whisperingin/hand-gesture-recognition/最终改print版本.txt

/* USER CODE BEGIN Header */
/**
  ******************************************************************************
  * @file           : main.c
  * @brief          : Main program body
  ******************************************************************************
  * @attention
  *
  * Copyright (c) 2026 STMicroelectronics.
  * All rights reserved.
  *
  * This software is licensed under terms that can be found in the LICENSE file
  * in the root directory of this software component.
  * If no LICENSE file comes with this software, it is provided AS-IS.
  *
  ******************************************************************************
  */
/* USER CODE END Header */
/* Includes ------------------------------------------------------------------*/
#include "main.h"

/* Private includes ----------------------------------------------------------*/
/* USER CODE BEGIN Includes */
#include <string.h>
/* USER CODE END Includes */

/* Private typedef -----------------------------------------------------------*/
/* USER CODE BEGIN PTD */
typedef struct {
    float x[3]; // 输入历史: x[n], x[n-1], x[n-2]
    float y[3]; // 输出历史: y[n], y[n-1], y[n-2]
    float b[3]; // 分子系数
    float a[3]; // 分母系数
} BiquadFilter;
/* USER CODE END PTD */

/* Private define ------------------------------------------------------------*/
/* USER CODE BEGIN PD */

/* USER CODE END PD */

/* Private macro -------------------------------------------------------------*/
/* USER CODE BEGIN PM */

/* USER CODE END PM */

/* Private variables ---------------------------------------------------------*/
ADC_HandleTypeDef hadc1;
DMA_HandleTypeDef hdma_adc1;

TIM_HandleTypeDef htim2;

UART_HandleTypeDef huart2;
DMA_HandleTypeDef hdma_usart2_tx;

/* USER CODE BEGIN PV */
#define N_CH 4
/* 每次处理多少帧，fs=2000Hz 时，20 帧表示 10 ms 一次处理 */
#define FRAMES_PER_BLOCK 20

#define ADC_HALF_LEN (N_CH * FRAMES_PER_BLOCK)
#define ADC_DMA_LEN  (2 * ADC_HALF_LEN)

/* CSV 很占空间，20 行一包建议至少 700 字节，这里留 1024 比较稳 */
#define TX_BUF_SIZE 1024

/* ADC DMA 循环双缓冲，数据排列为
   ch0 ch1 ch2 ch3 | ch0 ch1 ch2 ch3 | ...
*/
uint16_t adc_dma_buf[ADC_DMA_LEN];

/* DMA 半传输和全传输标志 */
volatile uint8_t adc_half_ready;
volatile uint8_t adc_full_ready;

/* 处理后的一个 block 输出缓冲 */
uint16_t filt_block[ADC_HALF_LEN];

/* 每个通道各自一套滤波器状态 */
BiquadFilter notch50[N_CH];
BiquadFilter highpass20[N_CH]; // 改为 20Hz
BiquadFilter lowpass400_s1[N_CH]; // 四阶滤波器的第一级
BiquadFilter lowpass400_s2[N_CH]; // 四阶滤波器的第二级

/* UART DMA 发送控制 */
volatile uint8_t uart_tx_busy;
uint8_t tx_buf[2][TX_BUF_SIZE];
volatile uint8_t tx_sel;
volatile uint32_t adc_half_overrun;
volatile uint32_t adc_full_overrun;
#define WARMUP_BLOCKS 50U   /* 50 block * 10 ms = 500 ms (fs=2000Hz, 20帧/block) */
volatile uint32_t warmup_left = WARMUP_BLOCKS;

/* USER CODE END PV */

/* Private function prototypes -----------------------------------------------*/
void SystemClock_Config(void);
static void MX_GPIO_Init(void);
static void MX_DMA_Init(void);
static void MX_USART2_UART_Init(void);
static void MX_ADC1_Init(void);
static void MX_TIM2_Init(void);
/* USER CODE BEGIN PFP */
static void ProcessBlock(const uint16_t* in, uint16_t* out, int frames);
static void TryUartSendCsvBlock(const uint16_t* out, int frames);
static inline int u16_to_ascii(uint16_t v, char *dst);
static inline int append_u16_csv4_line(char *dst, int remaining,
                                       uint16_t a, uint16_t b, uint16_t c, uint16_t d);
/* USER CODE END PFP */

/* Private user code ---------------------------------------------------------*/
/* USER CODE BEGIN 0 */
static void Filter_Init(void)
{
    for (int ch = 0; ch < N_CH; ch++)
    {
    	/* 50 Hz notch, fs=2000, Q=5 */
    	notch50[ch].b[0] = 0.9845975f;
    	notch50[ch].b[1] = -1.9449509f;
    	notch50[ch].b[2] = 0.9845975f;

    	notch50[ch].a[0] = 1.0f;
    	notch50[ch].a[1] = -1.9449509f;
    	notch50[ch].a[2] = 0.9691950f;

    	/* 20 Hz highpass, fs=2000, Butterworth Q=0.70710678 */
    	highpass20[ch].b[0] = 0.9565432f;
    	highpass20[ch].b[1] = -1.9130865f;
    	highpass20[ch].b[2] = 0.9565432f;

    	highpass20[ch].a[0] = 1.0f;
    	highpass20[ch].a[1] = -1.9111971f;
    	highpass20[ch].a[2] = 0.9149758f;

    	// 在 Filter_Init() 中替换原有的 lowpass400 初始化代码：

    	/* 400 Hz Lowpass, 4th-Order Butterworth, Stage 1 (Q=0.5412) */
    	lowpass400_s1[ch].b[0] = 0.183921f;
    	lowpass400_s1[ch].b[1] = 0.367842f;
    	lowpass400_s1[ch].b[2] = 0.183921f;
    	lowpass400_s1[ch].a[0] = 1.0f;
    	lowpass400_s1[ch].a[1] = -0.329007f;
    	lowpass400_s1[ch].a[2] = 0.064691f;

    	/* 400 Hz Lowpass, 4th-Order Butterworth, Stage 2 (Q=1.3065) */
    	lowpass400_s2[ch].b[0] = 0.253331f;
    	lowpass400_s2[ch].b[1] = 0.506662f;
    	lowpass400_s2[ch].b[2] = 0.253331f;
    	lowpass400_s2[ch].a[0] = 1.0f;
    	lowpass400_s2[ch].a[1] = -0.453228f;
    	lowpass400_s2[ch].a[2] = 0.466551f;

    	/* 别忘了把它们的状态变量 x[i] 和 y[i] 都在下方循环中初始化为 0.0f */

        /* 初始化所有状态变量为 0 */
        for (int i = 0; i < 3; i++)
        {
            notch50[ch].x[i] = 0.0f;
            notch50[ch].y[i] = 0.0f;

            highpass20[ch].x[i] = 0.0f;
            highpass20[ch].y[i] = 0.0f;

            // 新增：把第一级 (s1) 的输入输出历史清零
            lowpass400_s1[ch].x[i] = 0.0f;
            lowpass400_s1[ch].y[i] = 0.0f;

                        // 新增：把第二级 (s2) 的输入输出历史清零
            lowpass400_s2[ch].x[i] = 0.0f;
            lowpass400_s2[ch].y[i] = 0.0f;
        }
    }
}

static inline int u16_to_ascii(uint16_t v, char *dst)
{
    char tmp[5];
    int n = 0;
    int k = 0;

    if (v == 0)
    {
        dst[0] = '0';
        return 1;
    }

    while (v > 0)
    {
        tmp[n++] = (char)('0' + (v % 10));
        v /= 10;
    }

    while (n > 0)
    {
        dst[k++] = tmp[--n];
    }

    return k;
}

static inline int append_u16_csv4_line(char *dst, int remaining,
                                       uint16_t a, uint16_t b, uint16_t c, uint16_t d)
{
    int pos = 0;
    int n;

    n = u16_to_ascii(a, &dst[pos]);
    pos += n;
    if (pos >= remaining) return -1;
    dst[pos++] = ',';

    n = u16_to_ascii(b, &dst[pos]);
    pos += n;
    if (pos >= remaining) return -1;
    dst[pos++] = ',';

    n = u16_to_ascii(c, &dst[pos]);
    pos += n;
    if (pos >= remaining) return -1;
    dst[pos++] = ',';

    n = u16_to_ascii(d, &dst[pos]);
    pos += n;
    if (pos >= remaining) return -1;
    dst[pos++] = '\n';

    if (pos > remaining) return -1;
    return pos;
}

static inline float Biquad_Process(BiquadFilter *f, float input)
{
    f->x[2] = f->x[1];
    f->x[1] = f->x[0];
    f->x[0] = input;

    f->y[2] = f->y[1];
    f->y[1] = f->y[0];

    f->y[0] = (f->b[0] * f->x[0]) + (f->b[1] * f->x[1]) + (f->b[2] * f->x[2])
            - (f->a[1] * f->y[1]) - (f->a[2] * f->y[2]);

    return f->y[0];
}
#define ADC_MID 2048.0f

static void ProcessBlock(const uint16_t* in, uint16_t* out, int frames)
{
    for (int i = 0; i < frames; i++)
    {
        for (int ch = 0; ch < N_CH; ch++)
        {
            float raw = (float)in[i * N_CH + ch];

            /* 先减去直流中点，变成零均值信号 */
            float x0 = raw - ADC_MID;

            /* 1. 20Hz 高通滤波：滤除电极片晃动和极低频漂移 */
            float hp_out = Biquad_Process(&highpass20[ch], x0);

            /* 2. 50Hz 陷波滤波：滤除电网工频干扰 */
            float notch_out = Biquad_Process(&notch50[ch], hp_out);

            /* 3. 400Hz 四阶低通滤波 (级联两级) */
            float lp_out_s1 = Biquad_Process(&lowpass400_s1[ch], notch_out);
            float lp_out_s2 = Biquad_Process(&lowpass400_s2[ch], lp_out_s1); // 把 s1 的结果喂给 s2

            /* 再加回中值用于图表显示或上位机传输 */
            float final_f = lp_out_s2 + ADC_MID;

            /* 防止溢出截断 */
            if (final_f > 4095.0f) final_f = 4095.0f;
            if (final_f < 0.0f)    final_f = 0.0f;

            out[i * N_CH + ch] = (uint16_t)final_f;
        }
    }
}
static void TryUartSendCsvBlock(const uint16_t* out, int frames)
{
    if (uart_tx_busy) return;

    uint8_t sel = (uint8_t)(tx_sel ^ 1U);
    tx_sel = sel;

    int pos = 0;

    for (int i = 0; i < frames; i++)
    {
        int remaining = (int)TX_BUF_SIZE - pos;
        if (remaining < 32) break;

        int n = append_u16_csv4_line((char*)&tx_buf[sel][pos], remaining,
                                     out[i*N_CH + 0],
                                     out[i*N_CH + 1],
                                     out[i*N_CH + 2],
                                     out[i*N_CH + 3]);
        if (n < 0) break;

        pos += n;
    }

    if (pos <= 0) return;

    uart_tx_busy = 1;

    if (HAL_UART_Transmit_DMA(&huart2, tx_buf[sel], (uint16_t)pos) != HAL_OK)
    {
        uart_tx_busy = 0;
    }
}

/* USER CODE END 0 */

/**
  * @brief  The application entry point.
  * @retval int
  */
int main(void)
{

  /* USER CODE BEGIN 1 */

  /* USER CODE END 1 */

  /* MCU Configuration--------------------------------------------------------*/

  /* Reset of all peripherals, Initializes the Flash interface and the Systick. */
  HAL_Init();

  /* USER CODE BEGIN Init */
  DBGMCU->CR |= DBGMCU_CR_DBG_SLEEP;
  /* USER CODE END Init */

  /* Configure the system clock */
  SystemClock_Config();

  /* USER CODE BEGIN SysInit */

  /* USER CODE END SysInit */

  /* Initialize all configured peripherals */
  MX_GPIO_Init();
  MX_DMA_Init();
  MX_USART2_UART_Init();
  MX_ADC1_Init();
  MX_TIM2_Init();
  /* USER CODE BEGIN 2 */
    // 1. 初始化滤波器系数
    Filter_Init();

    // 2. 启动 ADC DMA
    if (HAL_ADC_Start_DMA(&hadc1, (uint32_t*)adc_dma_buf, ADC_DMA_LEN) != HAL_OK)
    {
        Error_Handler();
    }

    // 3. 启动定时器
    if (HAL_TIM_Base_Start(&htim2) != HAL_OK)
    {
        Error_Handler();
    }
#ifndef NDEBUG
  /* Debug build 不 suspend tick */
#else
  HAL_SuspendTick();
#endif

  /* USER CODE END 2 */

  /* Infinite loop */
  /* USER CODE BEGIN WHILE */
    while (1)
    {
    /* USER CODE END WHILE */

    /* USER CODE BEGIN 3 */

      if (adc_half_ready)
      {
          adc_half_ready = 0;

          /* 前半段 block 的起始地址 */
          const uint16_t* p = &adc_dma_buf[0];

          ProcessBlock(p, filt_block, FRAMES_PER_BLOCK);

          if (warmup_left > 0U)
          {
              warmup_left--;
          }
          else
          {
              TryUartSendCsvBlock(filt_block, FRAMES_PER_BLOCK);
          }

      }

      if (adc_full_ready)
      {
          adc_full_ready = 0;

          /* 后半段 block 的起始地址 */
          const uint16_t* p = &adc_dma_buf[ADC_HALF_LEN];

          ProcessBlock(p, filt_block, FRAMES_PER_BLOCK);

          if (warmup_left > 0U)
          {
              warmup_left--;
          }
          else
          {
              TryUartSendCsvBlock(filt_block, FRAMES_PER_BLOCK);
          }

      }

      /* 空闲就睡，等待 DMA 中断唤醒 */
#ifndef NDEBUG
  /* Debug build，先不睡，方便调试 */
#else
  if (!adc_half_ready && !adc_full_ready)
  {
    __WFI();
  }
#endif

    }
  /* USER CODE END 3 */
}

/**
  * @brief System Clock Configuration
  * @retval None
  */
void SystemClock_Config(void)
{
  RCC_OscInitTypeDef RCC_OscInitStruct = {0};
  RCC_ClkInitTypeDef RCC_ClkInitStruct = {0};

  /** Configure the main internal regulator output voltage
  */
  __HAL_RCC_PWR_CLK_ENABLE();
  __HAL_PWR_VOLTAGESCALING_CONFIG(PWR_REGULATOR_VOLTAGE_SCALE2);

  /** Initializes the RCC Oscillators according to the specified parameters
  * in the RCC_OscInitTypeDef structure.
  */
  RCC_OscInitStruct.OscillatorType = RCC_OSCILLATORTYPE_HSI;
  RCC_OscInitStruct.HSIState = RCC_HSI_ON;
  RCC_OscInitStruct.HSICalibrationValue = RCC_HSICALIBRATION_DEFAULT;
  RCC_OscInitStruct.PLL.PLLState = RCC_PLL_ON;
  RCC_OscInitStruct.PLL.PLLSource = RCC_PLLSOURCE_HSI;
  RCC_OscInitStruct.PLL.PLLM = 16;
  RCC_OscInitStruct.PLL.PLLN = 336;
  RCC_OscInitStruct.PLL.PLLP = RCC_PLLP_DIV4;
  RCC_OscInitStruct.PLL.PLLQ = 7;
  if (HAL_RCC_OscConfig(&RCC_OscInitStruct) != HAL_OK)
  {
    Error_Handler();
  }

  /** Initializes the CPU, AHB and APB buses clocks
  */
  RCC_ClkInitStruct.ClockType = RCC_CLOCKTYPE_HCLK|RCC_CLOCKTYPE_SYSCLK
                              |RCC_CLOCKTYPE_PCLK1|RCC_CLOCKTYPE_PCLK2;
  RCC_ClkInitStruct.SYSCLKSource = RCC_SYSCLKSOURCE_PLLCLK;
  RCC_ClkInitStruct.AHBCLKDivider = RCC_SYSCLK_DIV1;
  RCC_ClkInitStruct.APB1CLKDivider = RCC_HCLK_DIV2;
  RCC_ClkInitStruct.APB2CLKDivider = RCC_HCLK_DIV1;

  if (HAL_RCC_ClockConfig(&RCC_ClkInitStruct, FLASH_LATENCY_2) != HAL_OK)
  {
    Error_Handler();
  }
}

/**
  * @brief ADC1 Initialization Function
  * @param None
  * @retval None
  */
static void MX_ADC1_Init(void)
{

  /* USER CODE BEGIN ADC1_Init 0 */

  /* USER CODE END ADC1_Init 0 */

  ADC_ChannelConfTypeDef sConfig = {0};

  /* USER CODE BEGIN ADC1_Init 1 */

  /* USER CODE END ADC1_Init 1 */

  /** Configure the global features of the ADC (Clock, Resolution, Data Alignment and number of conversion)
  */
  hadc1.Instance = ADC1;
  hadc1.Init.ClockPrescaler = ADC_CLOCK_SYNC_PCLK_DIV4;
  hadc1.Init.Resolution = ADC_RESOLUTION_12B;
  hadc1.Init.ScanConvMode = ENABLE;
  hadc1.Init.ContinuousConvMode = DISABLE;
  hadc1.Init.DiscontinuousConvMode = DISABLE;
  hadc1.Init.ExternalTrigConvEdge = ADC_EXTERNALTRIGCONVEDGE_RISING;
  hadc1.Init.ExternalTrigConv = ADC_EXTERNALTRIGCONV_T2_TRGO;
  hadc1.Init.DataAlign = ADC_DATAALIGN_RIGHT;
  hadc1.Init.NbrOfConversion = 4;
  hadc1.Init.DMAContinuousRequests = ENABLE;
  hadc1.Init.EOCSelection = ADC_EOC_SEQ_CONV;
  if (HAL_ADC_Init(&hadc1) != HAL_OK)
  {
    Error_Handler();
  }

  /** Configure for the selected ADC regular channel its corresponding rank in the sequencer and its sample time.
  */
  sConfig.Channel = ADC_CHANNEL_0;
  sConfig.Rank = 1;
  sConfig.SamplingTime = ADC_SAMPLETIME_480CYCLES;
  if (HAL_ADC_ConfigChannel(&hadc1, &sConfig) != HAL_OK)
  {
    Error_Handler();
  }

  /** Configure for the selected ADC regular channel its corresponding rank in the sequencer and its sample time.
  */
  sConfig.Channel = ADC_CHANNEL_1;
  sConfig.Rank = 2;
  if (HAL_ADC_ConfigChannel(&hadc1, &sConfig) != HAL_OK)
  {
    Error_Handler();
  }

  /** Configure for the selected ADC regular channel its corresponding rank in the sequencer and its sample time.
  */
  sConfig.Channel = ADC_CHANNEL_4;
  sConfig.Rank = 3;
  if (HAL_ADC_ConfigChannel(&hadc1, &sConfig) != HAL_OK)
  {
    Error_Handler();
  }

  /** Configure for the selected ADC regular channel its corresponding rank in the sequencer and its sample time.
  */
  sConfig.Channel = ADC_CHANNEL_8;
  sConfig.Rank = 4;
  if (HAL_ADC_ConfigChannel(&hadc1, &sConfig) != HAL_OK)
  {
    Error_Handler();
  }
  /* USER CODE BEGIN ADC1_Init 2 */

  /* USER CODE END ADC1_Init 2 */

}

/**
  * @brief TIM2 Initialization Function
  * @param None
  * @retval None
  */
static void MX_TIM2_Init(void)
{

  /* USER CODE BEGIN TIM2_Init 0 */

  /* USER CODE END TIM2_Init 0 */

  TIM_ClockConfigTypeDef sClockSourceConfig = {0};
  TIM_MasterConfigTypeDef sMasterConfig = {0};

  /* USER CODE BEGIN TIM2_Init 1 */

  /* USER CODE END TIM2_Init 1 */
  htim2.Instance = TIM2;
  htim2.Init.Prescaler = 83;
  htim2.Init.CounterMode = TIM_COUNTERMODE_UP;
  htim2.Init.Period = 499;
  htim2.Init.ClockDivision = TIM_CLOCKDIVISION_DIV1;
  htim2.Init.AutoReloadPreload = TIM_AUTORELOAD_PRELOAD_DISABLE;
  if (HAL_TIM_Base_Init(&htim2) != HAL_OK)
  {
    Error_Handler();
  }
  sClockSourceConfig.ClockSource = TIM_CLOCKSOURCE_INTERNAL;
  if (HAL_TIM_ConfigClockSource(&htim2, &sClockSourceConfig) != HAL_OK)
  {
    Error_Handler();
  }
  sMasterConfig.MasterOutputTrigger = TIM_TRGO_UPDATE;
  sMasterConfig.MasterSlaveMode = TIM_MASTERSLAVEMODE_DISABLE;
  if (HAL_TIMEx_MasterConfigSynchronization(&htim2, &sMasterConfig) != HAL_OK)
  {
    Error_Handler();
  }
  /* USER CODE BEGIN TIM2_Init 2 */

  /* USER CODE END TIM2_Init 2 */

}

/**
  * @brief USART2 Initialization Function
  * @param None
  * @retval None
  */
static void MX_USART2_UART_Init(void)
{

  /* USER CODE BEGIN USART2_Init 0 */

  /* USER CODE END USART2_Init 0 */

  /* USER CODE BEGIN USART2_Init 1 */

  /* USER CODE END USART2_Init 1 */
  huart2.Instance = USART2;
  huart2.Init.BaudRate = 921600;
  huart2.Init.WordLength = UART_WORDLENGTH_8B;
  huart2.Init.StopBits = UART_STOPBITS_1;
  huart2.Init.Parity = UART_PARITY_NONE;
  huart2.Init.Mode = UART_MODE_TX_RX;
  huart2.Init.HwFlowCtl = UART_HWCONTROL_NONE;
  huart2.Init.OverSampling = UART_OVERSAMPLING_16;
  if (HAL_UART_Init(&huart2) != HAL_OK)
  {
    Error_Handler();
  }
  /* USER CODE BEGIN USART2_Init 2 */

  /* USER CODE END USART2_Init 2 */

}

/**
  * Enable DMA controller clock
  */
static void MX_DMA_Init(void)
{

  /* DMA controller clock enable */
  __HAL_RCC_DMA2_CLK_ENABLE();
  __HAL_RCC_DMA1_CLK_ENABLE();

  /* DMA interrupt init */
  /* DMA1_Stream6_IRQn interrupt configuration */
  HAL_NVIC_SetPriority(DMA1_Stream6_IRQn, 1, 0);
  HAL_NVIC_EnableIRQ(DMA1_Stream6_IRQn);
  /* DMA2_Stream0_IRQn interrupt configuration */
  HAL_NVIC_SetPriority(DMA2_Stream0_IRQn, 0, 0);
  HAL_NVIC_EnableIRQ(DMA2_Stream0_IRQn);

}

/**
  * @brief GPIO Initialization Function
  * @param None
  * @retval None
  */
static void MX_GPIO_Init(void)
{
  GPIO_InitTypeDef GPIO_InitStruct = {0};
  /* USER CODE BEGIN MX_GPIO_Init_1 */

  /* USER CODE END MX_GPIO_Init_1 */

  /* GPIO Ports Clock Enable */
  __HAL_RCC_GPIOC_CLK_ENABLE();
  __HAL_RCC_GPIOH_CLK_ENABLE();
  __HAL_RCC_GPIOA_CLK_ENABLE();
  __HAL_RCC_GPIOB_CLK_ENABLE();

  /*Configure GPIO pin Output Level */
  HAL_GPIO_WritePin(GPIOA, GPIO_PIN_5, GPIO_PIN_RESET);

  /*Configure GPIO pin : B1_Pin */
  GPIO_InitStruct.Pin = B1_Pin;
  GPIO_InitStruct.Mode = GPIO_MODE_IT_FALLING;
  GPIO_InitStruct.Pull = GPIO_NOPULL;
  HAL_GPIO_Init(B1_GPIO_Port, &GPIO_InitStruct);

  /*Configure GPIO pin : PA5 */
  GPIO_InitStruct.Pin = GPIO_PIN_5;
  GPIO_InitStruct.Mode = GPIO_MODE_OUTPUT_PP;
  GPIO_InitStruct.Pull = GPIO_NOPULL;
  GPIO_InitStruct.Speed = GPIO_SPEED_FREQ_LOW;
  HAL_GPIO_Init(GPIOA, &GPIO_InitStruct);

  /*Configure GPIO pin : PA8 */
  GPIO_InitStruct.Pin = GPIO_PIN_8;
  GPIO_InitStruct.Mode = GPIO_MODE_INPUT;
  GPIO_InitStruct.Pull = GPIO_PULLDOWN;
  HAL_GPIO_Init(GPIOA, &GPIO_InitStruct);

  /* USER CODE BEGIN MX_GPIO_Init_2 */

  /* USER CODE END MX_GPIO_Init_2 */
}

/* USER CODE BEGIN 4 */

/* ADC DMA 半传输完成回调：表示前半段缓冲区填满 */
void HAL_ADC_ConvHalfCpltCallback(ADC_HandleTypeDef* hadc)
{
    if (hadc->Instance == ADC1)
    {
        if (adc_half_ready)
        {
            adc_half_overrun++;
        }
        adc_half_ready = 1;
    }
}

/* ADC DMA 全传输完成回调：表示后半段缓冲区填满 */
void HAL_ADC_ConvCpltCallback(ADC_HandleTypeDef* hadc)
{
    if (hadc->Instance == ADC1)
    {
        if (adc_full_ready)
        {
            adc_full_overrun++;
        }
        adc_full_ready = 1;
    }
}

/* UART DMA 发送完成回调：释放 busy 标志 */
void HAL_UART_TxCpltCallback(UART_HandleTypeDef *huart)
{
    if (huart->Instance == USART2)
    {
        uart_tx_busy = 0;
    }
}
void HAL_UART_ErrorCallback(UART_HandleTypeDef *huart)
{
    if (huart->Instance == USART2)
    {
        uart_tx_busy = 0;
    }
}
/* USER CODE END 4 */

/**
  * @brief  This function is executed in case of error occurrence.
  * @retval None
  */
void Error_Handler(void)
{
  /* USER CODE BEGIN Error_Handler_Debug */
  /* User can add his own implementation to report the HAL error return state */
  __disable_irq();
  while (1)
  {
  }
  /* USER CODE END Error_Handler_Debug */
}

#ifdef  USE_FULL_ASSERT
/**
  * @brief  Reports the name of the source file and the source line number
  *         where the assert_param error has occurred.
  * @param  file: pointer to the source file name
  * @param  line: assert_param error line source number
  * @retval None
  */
void assert_failed(uint8_t *file, uint32_t line)
{
  /* USER CODE BEGIN 6 */
  /* User can add his own implementation to report the file name and line number,
     ex: printf("Wrong parameters value: file %s on line %d\r\n", file, line) */
  /* USER CODE END 6 */
}
#endif /* USE_FULL_ASSERT */
