whisperingin/hand-gesture-recognition/Draft2.asc

C1: cap; 0.1µ
C2: cap; 10µ
C3: cap; 470µ
C4: cap; 0.1µ
C5: cap; 100µ
C6: cap; 47µ
C7: cap; 0.1µ
C8: cap; 0.1µ
C9: cap; 47µ
C10: cap; 470µ
C11: cap; 4.7µ
C12: cap; 4.7µ
D1: schottky
L1: ind; 10µ
M1: pmos
R1: res; 1000k
R2: res; 1000k
R3: res; 10k
U1: LTC3106
V3: battery; 3.7
V4: cell; 0.5
Named nets: 0
.tran 100m startup
.op
