whisperingin/hand-gesture-recognition/(list of files, drawings)

Other design files:
no_ac_coupling_design(3).ms14
