whisperingin/hand-gesture-recognition/PCB_2_channel_version.kicad_pcb

## KiCad design PCB_2_channel_version.kicad_pcb (2026-03-01)

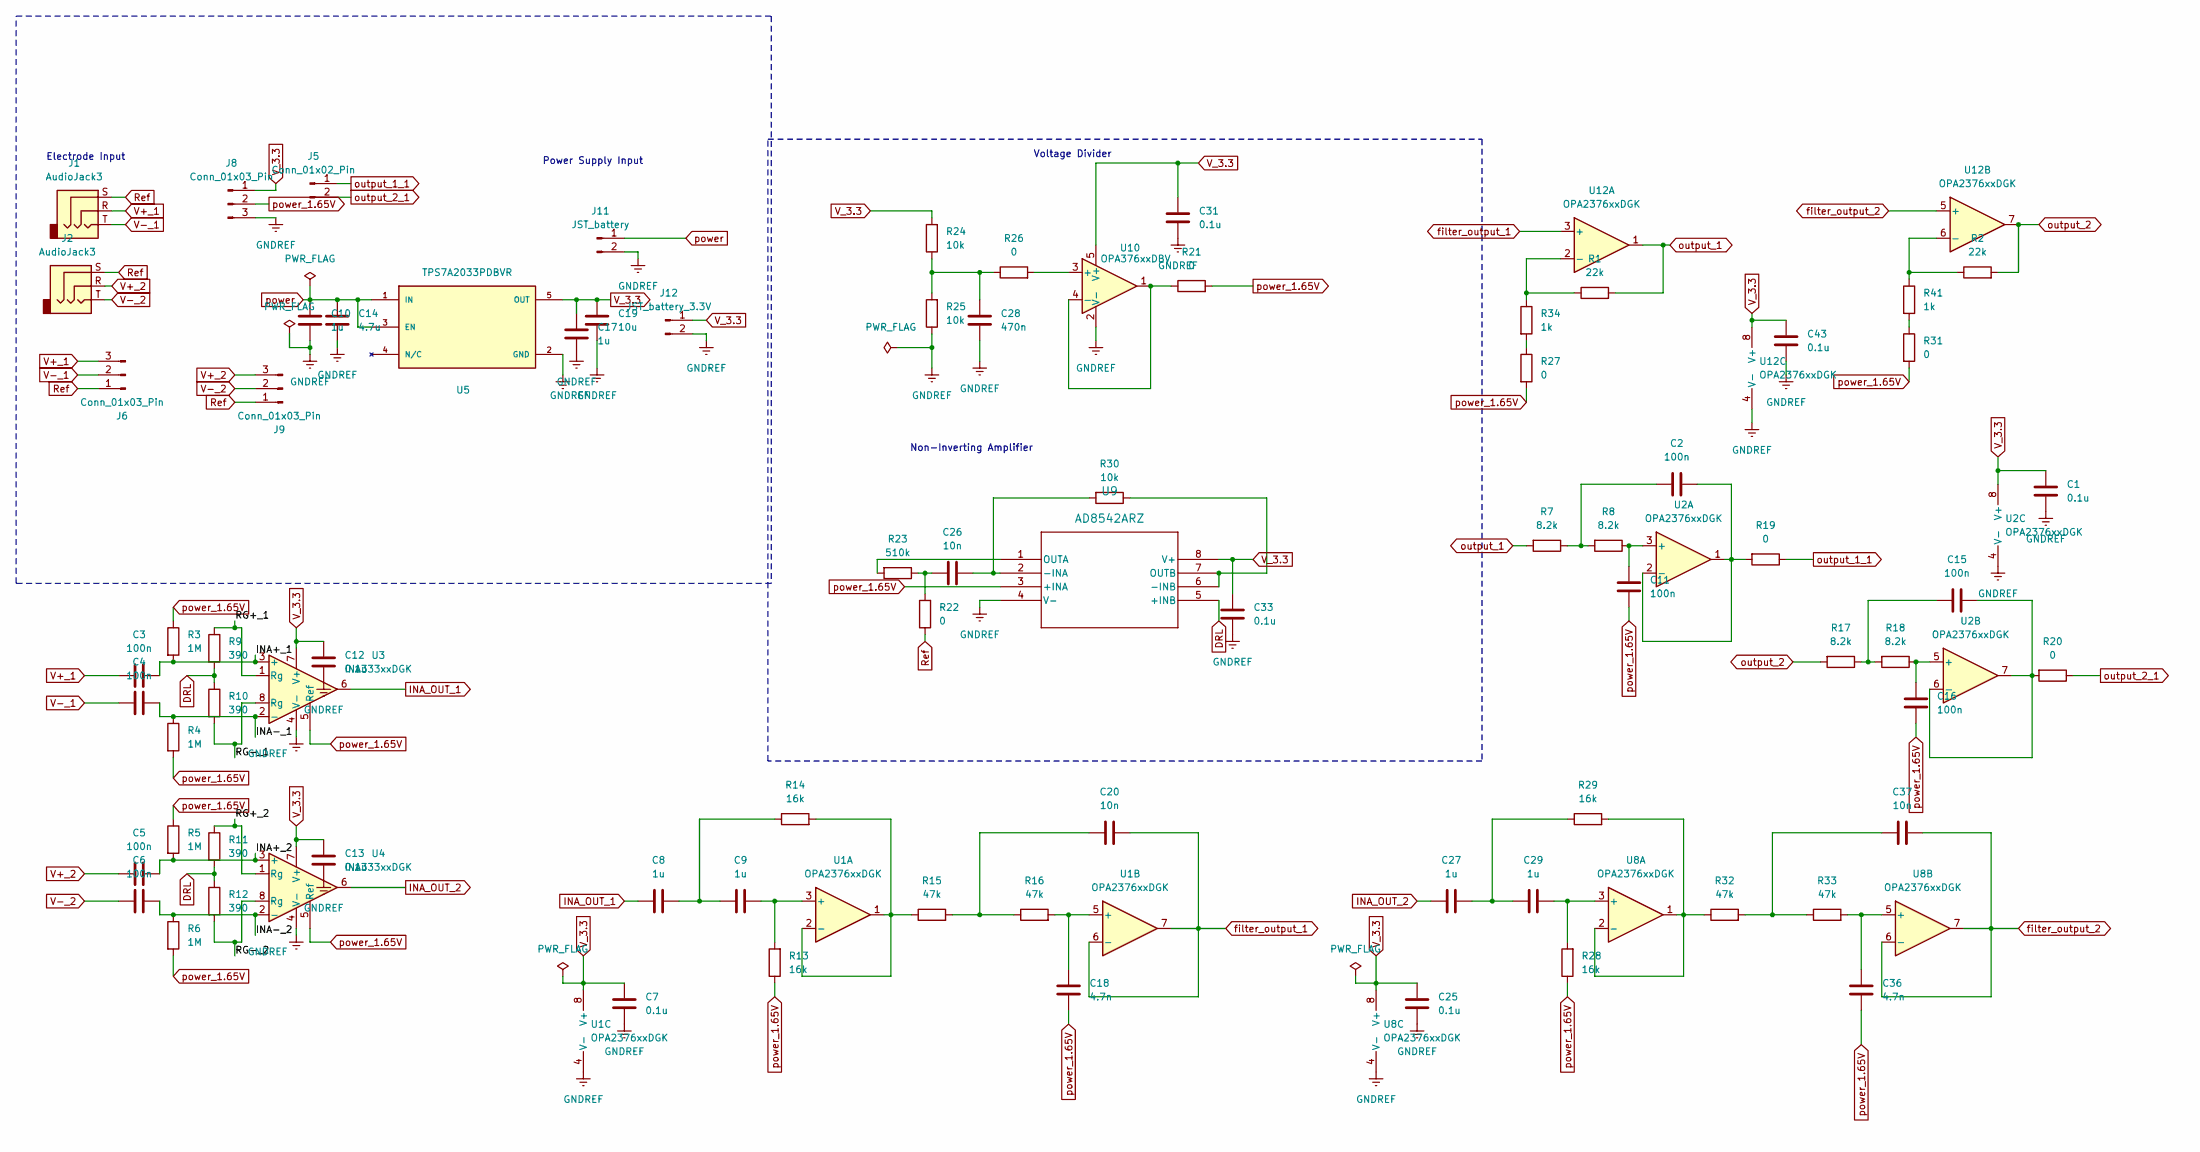
[picture p31: schematic PCB_2_channel_version.kicad_sch]

Parts:
C1, C7, C12, C13, C25, C31, C33, C43: 0.1u; C_0603_1608Metric_Pad1.08x0.95mm_HandSolder
C2, C11, C15, C16: 100n; C_0603_1608Metric_Pad1.08x0.95mm_HandSolder
C3, C4, C5, C6: 100n; C_0805_2012Metric_Pad1.18x1.45mm_HandSolder
C8, C9, C10, C17, C27, C29: 1u; C_0805_2012Metric_Pad1.18x1.45mm_HandSolder
C14: 4.7u; C_0805_2012Metric_Pad1.18x1.45mm_HandSolder
C18, C36: 4.7n; C_0805_2012Metric_Pad1.18x1.45mm_HandSolder
C19: 10u; C_0805_2012Metric_Pad1.18x1.45mm_HandSolder
C20, C26, C37: 10n; C_0805_2012Metric_Pad1.18x1.45mm_HandSolder
C28: 470n; C_0603_1608Metric_Pad1.08x0.95mm_HandSolder
J1, J2: AudioJack3; Jack_3.5mm_CUI_SJ-3523-SMT_Horizontal
J5: Conn_01x02_Pin; PinHeader_1x02_P2.54mm_Vertical
J6, J9: Conn_01x03_Pin; JST_PH_S3B-PH-K_1x03_P2.00mm_Horizontal
J8: Conn_01x03_Pin; PinHeader_1x03_P2.54mm_Vertical
J11: JST_battery; JST_PH_B2B-PH-K_1x02_P2.00mm_Vertical
J12: JST_battery_3.3V; JST_PH_B2B-PH-K_1x02_P2.00mm_Vertical
R1, R2: 22k; R_0805_2012Metric_Pad1.20x1.40mm_HandSolder
R3, R4, R5, R6: 1M; R_0805_2012Metric_Pad1.20x1.40mm_HandSolder
R7, R8, R17, R18: 8.2k; R_0603_1608Metric_Pad0.98x0.95mm_HandSolder
R9, R10, R11, R12: 390; R_0805_2012Metric_Pad1.20x1.40mm_HandSolder
R13, R14, R28, R29: 16k; R_0805_2012Metric_Pad1.20x1.40mm_HandSolder
R15, R16, R32, R33: 47k; R_0805_2012Metric_Pad1.20x1.40mm_HandSolder
R19, R20, R21, R22, R26: 0; R_0603_1608Metric_Pad0.98x0.95mm_HandSolder
R23: 510k; R_0805_2012Metric_Pad1.20x1.40mm_HandSolder
R24, R25: 10k; R_0603_1608Metric_Pad0.98x0.95mm_HandSolder
R27, R31: 0; R_0805_2012Metric_Pad1.20x1.40mm_HandSolder
R30: 10k; R_0805_2012Metric_Pad1.20x1.40mm_HandSolder
R34, R41: 1k; R_0805_2012Metric_Pad1.20x1.40mm_HandSolder
U1, U2, U8, U12: OPA2376xxDGK; DGK8
U3, U4: INA333xxDGK; VSSOP-8_3x3mm_P0.65mm
U5: TPS7A2033PDBVR; DBV0005A-IPC_B
U9: AD8542ARZ; R_8_ADI
U10: OPA376xxDBV; SOT-23-5

Connections:
/INA+_1: C3.1, R3.2, U3.3 (+)
/INA+_2: C5.1, R5.2, U4.3 (+)
/INA-_1: C4.1, R4.1, U3.2 (-)
/INA-_2: C6.1, R6.1, U4.2 (-)
/RG+_1: R9.1, U3.1 (Rg)
/RG+_2: R11.1, U4.1 (Rg)
/RG-_1: R10.2, U3.8 (Rg)
/RG-_2: R12.2, U4.8 (Rg)
DRL: R9.2, R10.1, R11.2, R12.1, U9.5 (+INB)
GNDREF: C1.2, C7.2, C10.2, C12.2, C13.2, C14.2, C17.2, C19.2, C25.2, C28.2, C31.2, C33.2, C43.2, J8.3, J11.2, J12.2, R25.1, U1.4 (V-), U2.4 (V-), U3.4 (V-), U4.4 (V-), U5.2 (GND), U8.4 (V-), U9.4 (V-), U10.2 (V-), U12.4 (V-)
INA_OUT_1: C8.2, U3.6
INA_OUT_2: C27.2, U4.6
unnamed: C2.1, R7.1, R8.2
unnamed: C8.1, C9.2, R14.1
unnamed: C15.1, R17.1, R18.2
unnamed: C20.2, R15.2, R16.1
unnamed: C26.2, R22.2, R23.1
unnamed: C27.1, C29.2, R29.1
unnamed: C28.1, R24.1, R25.2, R26.1
unnamed: C37.2, R32.2, R33.1
unnamed: R27.1, R34.2
unnamed: R31.1, R41.2
unnamed: C9.1, R13.2, U1.3 (+)
unnamed: R14.2, R15.1, U1.1, U1.2 (-)
unnamed: C18.1, R16.2, U1.5 (+)
unnamed: C11.2, R8.1, U2.3 (+)
unnamed: C2.2, R19.2, U2.1, U2.2 (-)
unnamed: C16.2, R18.1, U2.5 (+)
unnamed: C15.2, R20.2, U2.6 (-), U2.7
unnamed: C29.1, R28.2, U8.3 (+)
unnamed: R29.2, R32.1, U8.1, U8.2 (-)
unnamed: C36.1, R33.2, U8.5 (+)
unnamed: C26.1, R30.2, U9.2 (-INA)
unnamed: R30.1, U9.6 (-INB), U9.7 (OUTB)
unnamed: R23.2, U9.1 (OUTA)
unnamed: R26.2, U10.3 (+)
unnamed: R21.1, U10.1, U10.4 (-)
unnamed: R1.1, R34.1, U12.2 (-)
unnamed: R2.1, R41.1, U12.6 (-)
Ref: J1.S, J2.S, J6.1, J9.1, R22.1
V+_1: C3.2, J1.R, J6.3
V+_2: C5.2, J2.R, J9.3
V-_1: C4.2, J1.T, J6.2
V-_2: C6.2, J2.T, J9.2
V_3.3: C1.1, C7.1, C12.1, C13.1, C17.1, C19.1, C25.1, C31.1, C33.1, C43.1, J8.1, J12.1, R24.2, U1.8 (V+), U2.8 (V+), U3.7 (V+), U4.7 (V+), U5.5 (OUT), U8.8 (V+), U9.8 (V+), U10.5 (V+), U12.8 (V+)
filter_output_1: C20.1, U1.6 (-), U1.7, U12.3 (+)
filter_output_2: C37.1, U8.6 (-), U8.7, U12.5 (+)
output_1: R1.2, R7.2, U12.1
output_1_1: J5.1, R19.1
output_2: R2.2, R17.2, U12.7
output_2_1: J5.2, R20.1
power: C10.1, C14.1, J11.1, U5.1 (IN), U5.3 (EN)
power_1.65V: C11.1, C16.1, C18.2, C36.2, J8.2, R3.1, R4.2, R5.1, R6.2, R13.1, R21.2, R27.2, R28.1, R31.2, U3.5 (Ref), U4.5 (Ref), U9.3 (+INA)

Notes on the sheet:
Non-Inverting Amplifier
Electrode Input
Power Supply Input
Voltage Divider

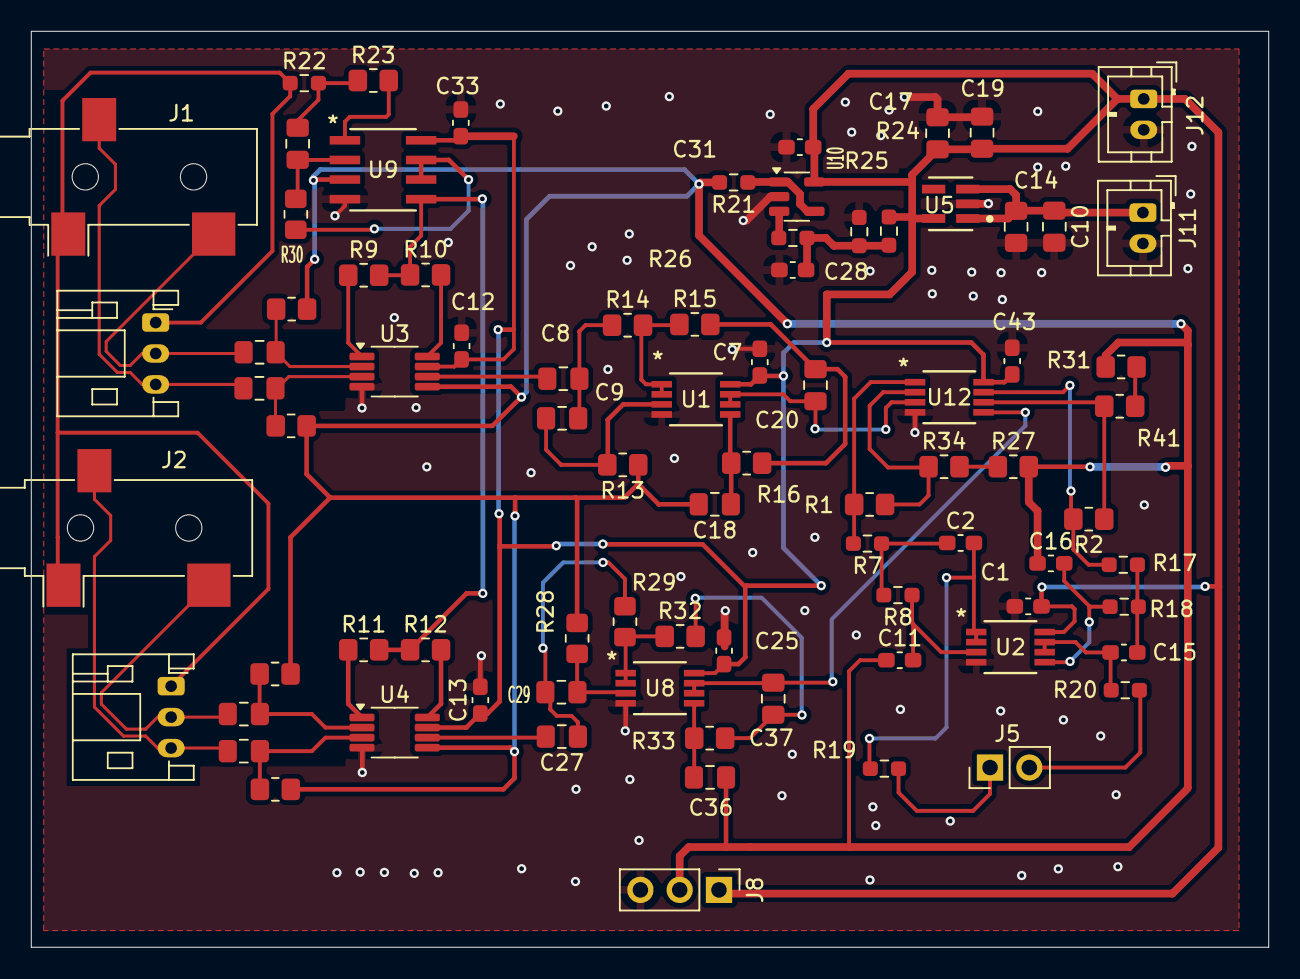
[picture p32: board PCB_2_channel_version.kicad_pcb from above]

Board: 2 copper layers, 80.0 x 59.2 mm, 82 parts (0 on the bottom side), 53 nets.
